dfantonio/Softstarter-using-ARM-STM32F411/latex/stm32f4xx__hal__msp_8c.tex

\hypertarget{stm32f4xx__hal__msp_8c}{}\section{Src/stm32f4xx\+\_\+hal\+\_\+msp.c File Reference}
\label{stm32f4xx__hal__msp_8c}\index{Src/stm32f4xx\+\_\+hal\+\_\+msp.\+c@{Src/stm32f4xx\+\_\+hal\+\_\+msp.\+c}}
{\ttfamily \#include \char`\"{}stm32f4xx\+\_\+hal.\+h\char`\"{}}\newline
\subsection*{Functions}
\begin{DoxyCompactItemize}
\item 
void \hyperlink{stm32f4xx__hal__msp_8c_a47642651029b93e3f9c9edad46bd27b4}{\+\_\+\+Error\+\_\+\+Handler} (char $\ast$, int)
\begin{DoxyCompactList}\small\item\em This function is executed in case of error occurrence. \end{DoxyCompactList}\item 
void \hyperlink{stm32f4xx__hal__msp_8c_ae4fb8e66865c87d0ebab74a726a6891f}{H\+A\+L\+\_\+\+Msp\+Init} (void)
\item 
void \hyperlink{stm32f4xx__hal__msp_8c_aa30863492d5c3103e3e8ce8a63dadd07}{H\+A\+L\+\_\+\+A\+D\+C\+\_\+\+Msp\+Init} (A\+D\+C\+\_\+\+Handle\+Type\+Def $\ast$hadc)
\item 
void \hyperlink{stm32f4xx__hal__msp_8c_a39b0f8e80268ab3e660ead921ad4b22f}{H\+A\+L\+\_\+\+A\+D\+C\+\_\+\+Msp\+De\+Init} (A\+D\+C\+\_\+\+Handle\+Type\+Def $\ast$hadc)
\item 
void \hyperlink{stm32f4xx__hal__msp_8c_abb25ade2f7e3f7aae167bd52270c2b86}{H\+A\+L\+\_\+\+T\+I\+M\+\_\+\+Base\+\_\+\+Msp\+Init} (T\+I\+M\+\_\+\+Handle\+Type\+Def $\ast$htim\+\_\+base)
\item 
void \hyperlink{stm32f4xx__hal__msp_8c_ae70bce6c39d0b570a7523b86738cec4b}{H\+A\+L\+\_\+\+T\+I\+M\+\_\+\+Msp\+Post\+Init} (T\+I\+M\+\_\+\+Handle\+Type\+Def $\ast$htim)
\item 
void \hyperlink{stm32f4xx__hal__msp_8c_a555b8a2d3c7a07341f8cb1255318fa2b}{H\+A\+L\+\_\+\+T\+I\+M\+\_\+\+Base\+\_\+\+Msp\+De\+Init} (T\+I\+M\+\_\+\+Handle\+Type\+Def $\ast$htim\+\_\+base)
\item 
void \hyperlink{stm32f4xx__hal__msp_8c_a0e553b32211877322f949b14801bbfa7}{H\+A\+L\+\_\+\+U\+A\+R\+T\+\_\+\+Msp\+Init} (U\+A\+R\+T\+\_\+\+Handle\+Type\+Def $\ast$huart)
\item 
void \hyperlink{stm32f4xx__hal__msp_8c_a718f39804e3b910d738a0e1e46151188}{H\+A\+L\+\_\+\+U\+A\+R\+T\+\_\+\+Msp\+De\+Init} (U\+A\+R\+T\+\_\+\+Handle\+Type\+Def $\ast$huart)
\end{DoxyCompactItemize}
\subsection*{Variables}
\begin{DoxyCompactItemize}
\item 
D\+M\+A\+\_\+\+Handle\+Type\+Def \hyperlink{stm32f4xx__hal__msp_8c_a1c126854bb1813d31ab4776b21dcc51f}{hdma\+\_\+adc1}
\end{DoxyCompactItemize}

\subsection{Function Documentation}
\mbox{\Hypertarget{stm32f4xx__hal__msp_8c_a47642651029b93e3f9c9edad46bd27b4}\label{stm32f4xx__hal__msp_8c_a47642651029b93e3f9c9edad46bd27b4}} 
\index{stm32f4xx\+\_\+hal\+\_\+msp.\+c@{stm32f4xx\+\_\+hal\+\_\+msp.\+c}!\+\_\+\+Error\+\_\+\+Handler@{\+\_\+\+Error\+\_\+\+Handler}}
\index{\+\_\+\+Error\+\_\+\+Handler@{\+\_\+\+Error\+\_\+\+Handler}!stm32f4xx\+\_\+hal\+\_\+msp.\+c@{stm32f4xx\+\_\+hal\+\_\+msp.\+c}}
\subsubsection{\texorpdfstring{\+\_\+\+Error\+\_\+\+Handler()}{\_Error\_Handler()}}
{\footnotesize\ttfamily void \+\_\+\+Error\+\_\+\+Handler (\begin{DoxyParamCaption}\item[{char $\ast$}]{file,  }\item[{int}]{line }\end{DoxyParamCaption})}

This function is executed in case of error occurrence. 

\begin{DoxyParams}{Parameters}
{\em file} & The file name as string. \\
\hline
{\em line} & The line in file as a number. \\
\hline
\end{DoxyParams}

\begin{DoxyRetVals}{Return values}
{\em None} & \\
\hline
\end{DoxyRetVals}

Definition at line 1010 of file main.\+c.

Referenced by H\+A\+L\+\_\+\+A\+D\+C\+\_\+\+Msp\+Init(), and System\+Clock\+\_\+\+Config().

\mbox{\Hypertarget{stm32f4xx__hal__msp_8c_a39b0f8e80268ab3e660ead921ad4b22f}\label{stm32f4xx__hal__msp_8c_a39b0f8e80268ab3e660ead921ad4b22f}} 
\index{stm32f4xx\+\_\+hal\+\_\+msp.\+c@{stm32f4xx\+\_\+hal\+\_\+msp.\+c}!H\+A\+L\+\_\+\+A\+D\+C\+\_\+\+Msp\+De\+Init@{H\+A\+L\+\_\+\+A\+D\+C\+\_\+\+Msp\+De\+Init}}
\index{H\+A\+L\+\_\+\+A\+D\+C\+\_\+\+Msp\+De\+Init@{H\+A\+L\+\_\+\+A\+D\+C\+\_\+\+Msp\+De\+Init}!stm32f4xx\+\_\+hal\+\_\+msp.\+c@{stm32f4xx\+\_\+hal\+\_\+msp.\+c}}
\subsubsection{\texorpdfstring{H\+A\+L\+\_\+\+A\+D\+C\+\_\+\+Msp\+De\+Init()}{HAL\_ADC\_MspDeInit()}}
{\footnotesize\ttfamily void H\+A\+L\+\_\+\+A\+D\+C\+\_\+\+Msp\+De\+Init (\begin{DoxyParamCaption}\item[{A\+D\+C\+\_\+\+Handle\+Type\+Def $\ast$}]{hadc }\end{DoxyParamCaption})}

A\+D\+C1 G\+P\+IO Configuration P\+A4 -\/-\/-\/---$>$ A\+D\+C1\+\_\+\+I\+N4

Definition at line 139 of file stm32f4xx\+\_\+hal\+\_\+msp.\+c.

\mbox{\Hypertarget{stm32f4xx__hal__msp_8c_aa30863492d5c3103e3e8ce8a63dadd07}\label{stm32f4xx__hal__msp_8c_aa30863492d5c3103e3e8ce8a63dadd07}} 
\index{stm32f4xx\+\_\+hal\+\_\+msp.\+c@{stm32f4xx\+\_\+hal\+\_\+msp.\+c}!H\+A\+L\+\_\+\+A\+D\+C\+\_\+\+Msp\+Init@{H\+A\+L\+\_\+\+A\+D\+C\+\_\+\+Msp\+Init}}
\index{H\+A\+L\+\_\+\+A\+D\+C\+\_\+\+Msp\+Init@{H\+A\+L\+\_\+\+A\+D\+C\+\_\+\+Msp\+Init}!stm32f4xx\+\_\+hal\+\_\+msp.\+c@{stm32f4xx\+\_\+hal\+\_\+msp.\+c}}
\subsubsection{\texorpdfstring{H\+A\+L\+\_\+\+A\+D\+C\+\_\+\+Msp\+Init()}{HAL\_ADC\_MspInit()}}
{\footnotesize\ttfamily void H\+A\+L\+\_\+\+A\+D\+C\+\_\+\+Msp\+Init (\begin{DoxyParamCaption}\item[{A\+D\+C\+\_\+\+Handle\+Type\+Def $\ast$}]{hadc }\end{DoxyParamCaption})}

A\+D\+C1 G\+P\+IO Configuration P\+A4 -\/-\/-\/---$>$ A\+D\+C1\+\_\+\+I\+N4

Definition at line 90 of file stm32f4xx\+\_\+hal\+\_\+msp.\+c.

References \+\_\+\+Error\+\_\+\+Handler(), and hdma\+\_\+adc1.

\mbox{\Hypertarget{stm32f4xx__hal__msp_8c_ae4fb8e66865c87d0ebab74a726a6891f}\label{stm32f4xx__hal__msp_8c_ae4fb8e66865c87d0ebab74a726a6891f}} 
\index{stm32f4xx\+\_\+hal\+\_\+msp.\+c@{stm32f4xx\+\_\+hal\+\_\+msp.\+c}!H\+A\+L\+\_\+\+Msp\+Init@{H\+A\+L\+\_\+\+Msp\+Init}}
\index{H\+A\+L\+\_\+\+Msp\+Init@{H\+A\+L\+\_\+\+Msp\+Init}!stm32f4xx\+\_\+hal\+\_\+msp.\+c@{stm32f4xx\+\_\+hal\+\_\+msp.\+c}}
\subsubsection{\texorpdfstring{H\+A\+L\+\_\+\+Msp\+Init()}{HAL\_MspInit()}}
{\footnotesize\ttfamily void H\+A\+L\+\_\+\+Msp\+Init (\begin{DoxyParamCaption}\item[{void}]{ }\end{DoxyParamCaption})}

Initializes the Global M\+SP. 

Definition at line 61 of file stm32f4xx\+\_\+hal\+\_\+msp.\+c.

\mbox{\Hypertarget{stm32f4xx__hal__msp_8c_a555b8a2d3c7a07341f8cb1255318fa2b}\label{stm32f4xx__hal__msp_8c_a555b8a2d3c7a07341f8cb1255318fa2b}} 
\index{stm32f4xx\+\_\+hal\+\_\+msp.\+c@{stm32f4xx\+\_\+hal\+\_\+msp.\+c}!H\+A\+L\+\_\+\+T\+I\+M\+\_\+\+Base\+\_\+\+Msp\+De\+Init@{H\+A\+L\+\_\+\+T\+I\+M\+\_\+\+Base\+\_\+\+Msp\+De\+Init}}
\index{H\+A\+L\+\_\+\+T\+I\+M\+\_\+\+Base\+\_\+\+Msp\+De\+Init@{H\+A\+L\+\_\+\+T\+I\+M\+\_\+\+Base\+\_\+\+Msp\+De\+Init}!stm32f4xx\+\_\+hal\+\_\+msp.\+c@{stm32f4xx\+\_\+hal\+\_\+msp.\+c}}
\subsubsection{\texorpdfstring{H\+A\+L\+\_\+\+T\+I\+M\+\_\+\+Base\+\_\+\+Msp\+De\+Init()}{HAL\_TIM\_Base\_MspDeInit()}}
{\footnotesize\ttfamily void H\+A\+L\+\_\+\+T\+I\+M\+\_\+\+Base\+\_\+\+Msp\+De\+Init (\begin{DoxyParamCaption}\item[{T\+I\+M\+\_\+\+Handle\+Type\+Def $\ast$}]{htim\+\_\+base }\end{DoxyParamCaption})}

T\+I\+M1 G\+P\+IO Configuration P\+A8 ------$>$ T\+I\+M1\+\_\+\+C\+H1

T\+I\+M2 G\+P\+IO Configuration P\+A0-\/\+W\+K\+UP ------$>$ T\+I\+M2\+\_\+\+C\+H1 P\+A1 ------$>$ T\+I\+M2\+\_\+\+C\+H2

T\+I\+M4 G\+P\+IO Configuration P\+B6 -\/-\/-\/---$>$ T\+I\+M4\+\_\+\+C\+H1

Definition at line 284 of file stm32f4xx\+\_\+hal\+\_\+msp.\+c.

\mbox{\Hypertarget{stm32f4xx__hal__msp_8c_abb25ade2f7e3f7aae167bd52270c2b86}\label{stm32f4xx__hal__msp_8c_abb25ade2f7e3f7aae167bd52270c2b86}} 
\index{stm32f4xx\+\_\+hal\+\_\+msp.\+c@{stm32f4xx\+\_\+hal\+\_\+msp.\+c}!H\+A\+L\+\_\+\+T\+I\+M\+\_\+\+Base\+\_\+\+Msp\+Init@{H\+A\+L\+\_\+\+T\+I\+M\+\_\+\+Base\+\_\+\+Msp\+Init}}
\index{H\+A\+L\+\_\+\+T\+I\+M\+\_\+\+Base\+\_\+\+Msp\+Init@{H\+A\+L\+\_\+\+T\+I\+M\+\_\+\+Base\+\_\+\+Msp\+Init}!stm32f4xx\+\_\+hal\+\_\+msp.\+c@{stm32f4xx\+\_\+hal\+\_\+msp.\+c}}
\subsubsection{\texorpdfstring{H\+A\+L\+\_\+\+T\+I\+M\+\_\+\+Base\+\_\+\+Msp\+Init()}{HAL\_TIM\_Base\_MspInit()}}
{\footnotesize\ttfamily void H\+A\+L\+\_\+\+T\+I\+M\+\_\+\+Base\+\_\+\+Msp\+Init (\begin{DoxyParamCaption}\item[{T\+I\+M\+\_\+\+Handle\+Type\+Def $\ast$}]{htim\+\_\+base }\end{DoxyParamCaption})}

T\+I\+M1 G\+P\+IO Configuration P\+A8 ------$>$ T\+I\+M1\+\_\+\+C\+H1

T\+I\+M2 G\+P\+IO Configuration P\+A1 ------$>$ T\+I\+M2\+\_\+\+C\+H2

T\+I\+M4 G\+P\+IO Configuration P\+B6 -\/-\/-\/---$>$ T\+I\+M4\+\_\+\+C\+H1

Definition at line 167 of file stm32f4xx\+\_\+hal\+\_\+msp.\+c.

\mbox{\Hypertarget{stm32f4xx__hal__msp_8c_ae70bce6c39d0b570a7523b86738cec4b}\label{stm32f4xx__hal__msp_8c_ae70bce6c39d0b570a7523b86738cec4b}} 
\index{stm32f4xx\+\_\+hal\+\_\+msp.\+c@{stm32f4xx\+\_\+hal\+\_\+msp.\+c}!H\+A\+L\+\_\+\+T\+I\+M\+\_\+\+Msp\+Post\+Init@{H\+A\+L\+\_\+\+T\+I\+M\+\_\+\+Msp\+Post\+Init}}
\index{H\+A\+L\+\_\+\+T\+I\+M\+\_\+\+Msp\+Post\+Init@{H\+A\+L\+\_\+\+T\+I\+M\+\_\+\+Msp\+Post\+Init}!stm32f4xx\+\_\+hal\+\_\+msp.\+c@{stm32f4xx\+\_\+hal\+\_\+msp.\+c}}
\subsubsection{\texorpdfstring{H\+A\+L\+\_\+\+T\+I\+M\+\_\+\+Msp\+Post\+Init()}{HAL\_TIM\_MspPostInit()}}
{\footnotesize\ttfamily void H\+A\+L\+\_\+\+T\+I\+M\+\_\+\+Msp\+Post\+Init (\begin{DoxyParamCaption}\item[{T\+I\+M\+\_\+\+Handle\+Type\+Def $\ast$}]{htim }\end{DoxyParamCaption})}

T\+I\+M2 G\+P\+IO Configuration P\+A0-\/\+W\+K\+UP -\/-\/-\/---$>$ T\+I\+M2\+\_\+\+C\+H1

Definition at line 257 of file stm32f4xx\+\_\+hal\+\_\+msp.\+c.

\mbox{\Hypertarget{stm32f4xx__hal__msp_8c_a718f39804e3b910d738a0e1e46151188}\label{stm32f4xx__hal__msp_8c_a718f39804e3b910d738a0e1e46151188}} 
\index{stm32f4xx\+\_\+hal\+\_\+msp.\+c@{stm32f4xx\+\_\+hal\+\_\+msp.\+c}!H\+A\+L\+\_\+\+U\+A\+R\+T\+\_\+\+Msp\+De\+Init@{H\+A\+L\+\_\+\+U\+A\+R\+T\+\_\+\+Msp\+De\+Init}}
\index{H\+A\+L\+\_\+\+U\+A\+R\+T\+\_\+\+Msp\+De\+Init@{H\+A\+L\+\_\+\+U\+A\+R\+T\+\_\+\+Msp\+De\+Init}!stm32f4xx\+\_\+hal\+\_\+msp.\+c@{stm32f4xx\+\_\+hal\+\_\+msp.\+c}}
\subsubsection{\texorpdfstring{H\+A\+L\+\_\+\+U\+A\+R\+T\+\_\+\+Msp\+De\+Init()}{HAL\_UART\_MspDeInit()}}
{\footnotesize\ttfamily void H\+A\+L\+\_\+\+U\+A\+R\+T\+\_\+\+Msp\+De\+Init (\begin{DoxyParamCaption}\item[{U\+A\+R\+T\+\_\+\+Handle\+Type\+Def $\ast$}]{huart }\end{DoxyParamCaption})}

U\+S\+A\+R\+T2 G\+P\+IO Configuration P\+A2 -\/-\/-\/---$>$ U\+S\+A\+R\+T2\+\_\+\+TX P\+A3 -\/-\/-\/---$>$ U\+S\+A\+R\+T2\+\_\+\+RX

Definition at line 390 of file stm32f4xx\+\_\+hal\+\_\+msp.\+c.

\mbox{\Hypertarget{stm32f4xx__hal__msp_8c_a0e553b32211877322f949b14801bbfa7}\label{stm32f4xx__hal__msp_8c_a0e553b32211877322f949b14801bbfa7}} 
\index{stm32f4xx\+\_\+hal\+\_\+msp.\+c@{stm32f4xx\+\_\+hal\+\_\+msp.\+c}!H\+A\+L\+\_\+\+U\+A\+R\+T\+\_\+\+Msp\+Init@{H\+A\+L\+\_\+\+U\+A\+R\+T\+\_\+\+Msp\+Init}}
\index{H\+A\+L\+\_\+\+U\+A\+R\+T\+\_\+\+Msp\+Init@{H\+A\+L\+\_\+\+U\+A\+R\+T\+\_\+\+Msp\+Init}!stm32f4xx\+\_\+hal\+\_\+msp.\+c@{stm32f4xx\+\_\+hal\+\_\+msp.\+c}}
\subsubsection{\texorpdfstring{H\+A\+L\+\_\+\+U\+A\+R\+T\+\_\+\+Msp\+Init()}{HAL\_UART\_MspInit()}}
{\footnotesize\ttfamily void H\+A\+L\+\_\+\+U\+A\+R\+T\+\_\+\+Msp\+Init (\begin{DoxyParamCaption}\item[{U\+A\+R\+T\+\_\+\+Handle\+Type\+Def $\ast$}]{huart }\end{DoxyParamCaption})}

U\+S\+A\+R\+T2 G\+P\+IO Configuration P\+A2 -\/-\/-\/---$>$ U\+S\+A\+R\+T2\+\_\+\+TX P\+A3 -\/-\/-\/---$>$ U\+S\+A\+R\+T2\+\_\+\+RX

Definition at line 357 of file stm32f4xx\+\_\+hal\+\_\+msp.\+c.

\subsection{Variable Documentation}
\mbox{\Hypertarget{stm32f4xx__hal__msp_8c_a1c126854bb1813d31ab4776b21dcc51f}\label{stm32f4xx__hal__msp_8c_a1c126854bb1813d31ab4776b21dcc51f}} 
\index{stm32f4xx\+\_\+hal\+\_\+msp.\+c@{stm32f4xx\+\_\+hal\+\_\+msp.\+c}!hdma\+\_\+adc1@{hdma\+\_\+adc1}}
\index{hdma\+\_\+adc1@{hdma\+\_\+adc1}!stm32f4xx\+\_\+hal\+\_\+msp.\+c@{stm32f4xx\+\_\+hal\+\_\+msp.\+c}}
\subsubsection{\texorpdfstring{hdma\+\_\+adc1}{hdma\_adc1}}
{\footnotesize\ttfamily D\+M\+A\+\_\+\+Handle\+Type\+Def hdma\+\_\+adc1}

File Name \+: \hyperlink{stm32f4xx__hal__msp_8c}{stm32f4xx\+\_\+hal\+\_\+msp.\+c} Description \+: This file provides code for the M\+SP Initialization and de-\/\+Initialization codes.

This notice applies to any and all portions of this file that are not between comment pairs U\+S\+ER C\+O\+DE B\+E\+G\+IN and U\+S\+ER C\+O\+DE E\+ND. Other portions of this file, whether inserted by the user or by software development tools are owned by their respective copyright owners.

Copyright (c) 2018 S\+T\+Microelectronics International N.\+V. All rights reserved.

Redistribution and use in source and binary forms, with or without modification, are permitted, provided that the following conditions are met\+:

\begin{DoxyEnumerate}
\item Redistribution of source code must retain the above copyright notice, this list of conditions and the following disclaimer.
\item Redistributions in binary form must reproduce the above copyright notice, this list of conditions and the following disclaimer in the documentation and/or other materials provided with the distribution.
\item Neither the name of S\+T\+Microelectronics nor the names of other contributors to this software may be used to endorse or promote products derived from this software without specific written permission.
\item This software, including modifications and/or derivative works of this software, must execute solely and exclusively on microcontroller or microprocessor devices manufactured by or for S\+T\+Microelectronics.
\item Redistribution and use of this software other than as permitted under this license is void and will automatically terminate your rights under this license.
\end{DoxyEnumerate}

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

Definition at line 61 of file main.\+c.

Referenced by H\+A\+L\+\_\+\+A\+D\+C\+\_\+\+Msp\+Init().
