dfantonio/Softstarter-using-ARM-STM32F411/latex/modules.tex

\section{Modules}
Here is a list of all modules\+:\begin{DoxyCompactList}
\item \contentsline{section}{S\+T\+M32\+F7xx\+\_\+\+H\+A\+L\+\_\+\+Examples}{\pageref{group___s_t_m32_f7xx___h_a_l___examples}}{}
\begin{DoxyCompactList}
\item \contentsline{section}{H\+A\+L\+\_\+\+Time\+Base}{\pageref{group___h_a_l___time_base}}{}
\end{DoxyCompactList}
\item \contentsline{section}{C\+M\+S\+IS}{\pageref{group___c_m_s_i_s}}{}
\begin{DoxyCompactList}
\item \contentsline{section}{Stm32f4xx\+\_\+system}{\pageref{group__stm32f4xx__system}}{}
\begin{DoxyCompactList}
\item \contentsline{section}{S\+T\+M32\+F4xx\+\_\+\+System\+\_\+\+Private\+\_\+\+Includes}{\pageref{group___s_t_m32_f4xx___system___private___includes}}{}
\item \contentsline{section}{S\+T\+M32\+F4xx\+\_\+\+System\+\_\+\+Private\+\_\+\+Types\+Definitions}{\pageref{group___s_t_m32_f4xx___system___private___types_definitions}}{}
\item \contentsline{section}{S\+T\+M32\+F4xx\+\_\+\+System\+\_\+\+Private\+\_\+\+Defines}{\pageref{group___s_t_m32_f4xx___system___private___defines}}{}
\item \contentsline{section}{S\+T\+M32\+F4xx\+\_\+\+System\+\_\+\+Private\+\_\+\+Macros}{\pageref{group___s_t_m32_f4xx___system___private___macros}}{}
\item \contentsline{section}{S\+T\+M32\+F4xx\+\_\+\+System\+\_\+\+Private\+\_\+\+Variables}{\pageref{group___s_t_m32_f4xx___system___private___variables}}{}
\item \contentsline{section}{S\+T\+M32\+F4xx\+\_\+\+System\+\_\+\+Private\+\_\+\+Function\+Prototypes}{\pageref{group___s_t_m32_f4xx___system___private___function_prototypes}}{}
\item \contentsline{section}{S\+T\+M32\+F4xx\+\_\+\+System\+\_\+\+Private\+\_\+\+Functions}{\pageref{group___s_t_m32_f4xx___system___private___functions}}{}
\end{DoxyCompactList}
\end{DoxyCompactList}
\end{DoxyCompactList}
