dfantonio/Softstarter-using-ARM-STM32F411/latex/stm32f4xx__hal__timebase___t_i_m_8c.tex

\hypertarget{stm32f4xx__hal__timebase___t_i_m_8c}{}\section{Src/stm32f4xx\+\_\+hal\+\_\+timebase\+\_\+\+T\+IM.c File Reference}
\label{stm32f4xx__hal__timebase___t_i_m_8c}\index{Src/stm32f4xx\+\_\+hal\+\_\+timebase\+\_\+\+T\+I\+M.\+c@{Src/stm32f4xx\+\_\+hal\+\_\+timebase\+\_\+\+T\+I\+M.\+c}}

H\+AL time base based on the hardware T\+IM.  

{\ttfamily \#include \char`\"{}stm32f4xx\+\_\+hal.\+h\char`\"{}}\newline
{\ttfamily \#include \char`\"{}stm32f4xx\+\_\+hal\+\_\+tim.\+h\char`\"{}}\newline
\subsection*{Functions}
\begin{DoxyCompactItemize}
\item 
H\+A\+L\+\_\+\+Status\+Type\+Def \hyperlink{group___h_a_l___time_base_ga879cdb21ef051eb81ec51c18147397d5}{H\+A\+L\+\_\+\+Init\+Tick} (uint32\+\_\+t Tick\+Priority)
\begin{DoxyCompactList}\small\item\em This function configures the T\+I\+M11 as a time base source. The time source is configured to have 1ms time base with a dedicated Tick interrupt priority. \end{DoxyCompactList}\item 
void \hyperlink{group___h_a_l___time_base_gaaf651af2afe688a991c657f64f8fa5f9}{H\+A\+L\+\_\+\+Suspend\+Tick} (void)
\begin{DoxyCompactList}\small\item\em Suspend Tick increment. \end{DoxyCompactList}\item 
void \hyperlink{group___h_a_l___time_base_ga24e0ee9dae1ec0f9d19200f5575ff790}{H\+A\+L\+\_\+\+Resume\+Tick} (void)
\begin{DoxyCompactList}\small\item\em Resume Tick increment. \end{DoxyCompactList}\end{DoxyCompactItemize}
\subsection*{Variables}
\begin{DoxyCompactItemize}
\item 
T\+I\+M\+\_\+\+Handle\+Type\+Def \hyperlink{group___h_a_l___time_base_ga2f22f985c4f33318fdcd4cc996623bf4}{htim11}
\item 
uint32\+\_\+t \hyperlink{group___h_a_l___time_base_gad252e5fa14fe03797c816cfb14962693}{uw\+Increment\+State} = 0
\end{DoxyCompactItemize}

\subsection{Detailed Description}
H\+AL time base based on the hardware T\+IM. 

This notice applies to any and all portions of this file that are not between comment pairs U\+S\+ER C\+O\+DE B\+E\+G\+IN and U\+S\+ER C\+O\+DE E\+ND. Other portions of this file, whether inserted by the user or by software development tools are owned by their respective copyright owners.

Copyright (c) 2018 S\+T\+Microelectronics International N.\+V. All rights reserved.

Redistribution and use in source and binary forms, with or without modification, are permitted, provided that the following conditions are met\+:

\begin{DoxyEnumerate}
\item Redistribution of source code must retain the above copyright notice, this list of conditions and the following disclaimer.
\item Redistributions in binary form must reproduce the above copyright notice, this list of conditions and the following disclaimer in the documentation and/or other materials provided with the distribution.
\item Neither the name of S\+T\+Microelectronics nor the names of other contributors to this software may be used to endorse or promote products derived from this software without specific written permission.
\item This software, including modifications and/or derivative works of this software, must execute solely and exclusively on microcontroller or microprocessor devices manufactured by or for S\+T\+Microelectronics.
\item Redistribution and use of this software other than as permitted under this license is void and will automatically terminate your rights under this license.
\end{DoxyEnumerate}

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
