dfantonio/Softstarter-using-ARM-STM32F411/Relatório/Diagrama da SoftStarter.png

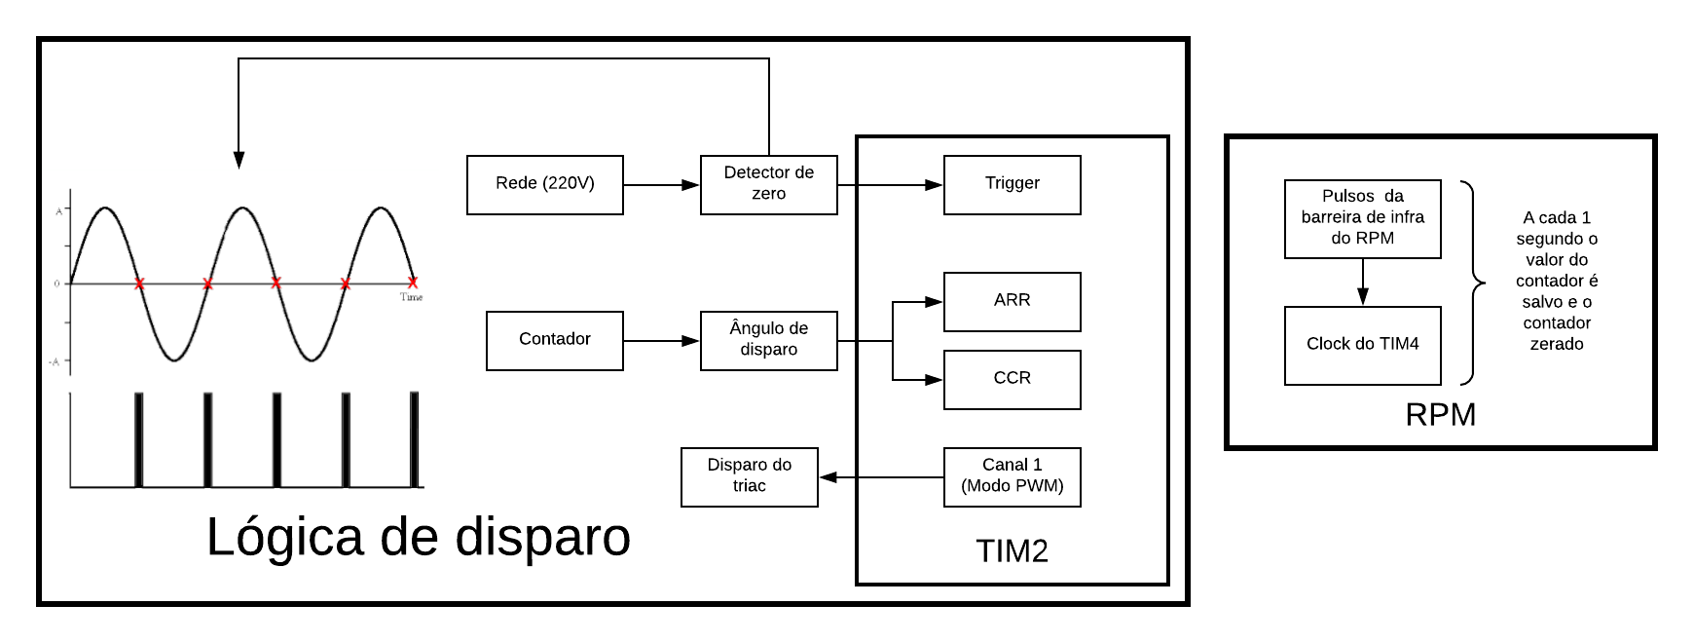
Relatório/Diagrama da SoftStarter.png
