dfantonio/Softstarter-using-ARM-STM32F411/Schematics/Disparo pro TRIAC.png

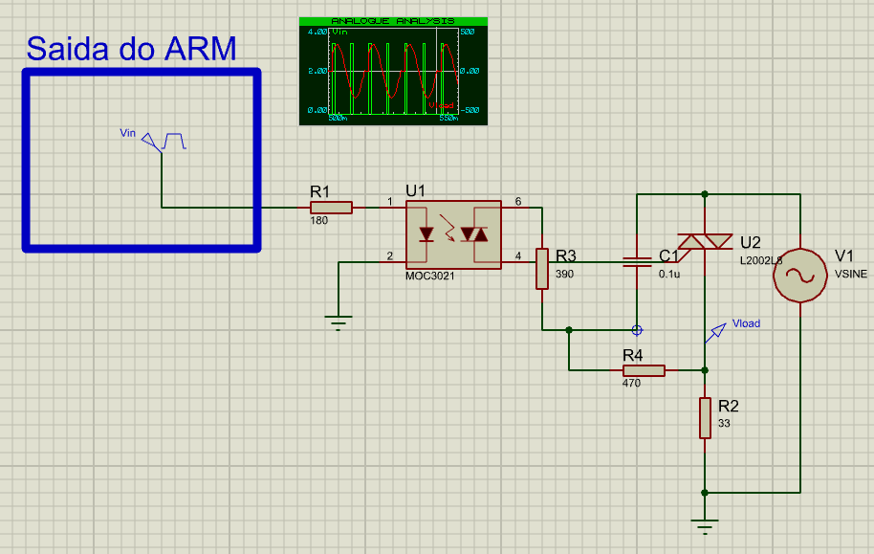
Schematics/Disparo pro TRIAC.png
