dfantonio/Softstarter-using-ARM-STM32F411/Schematics/Retificador de precisão.png

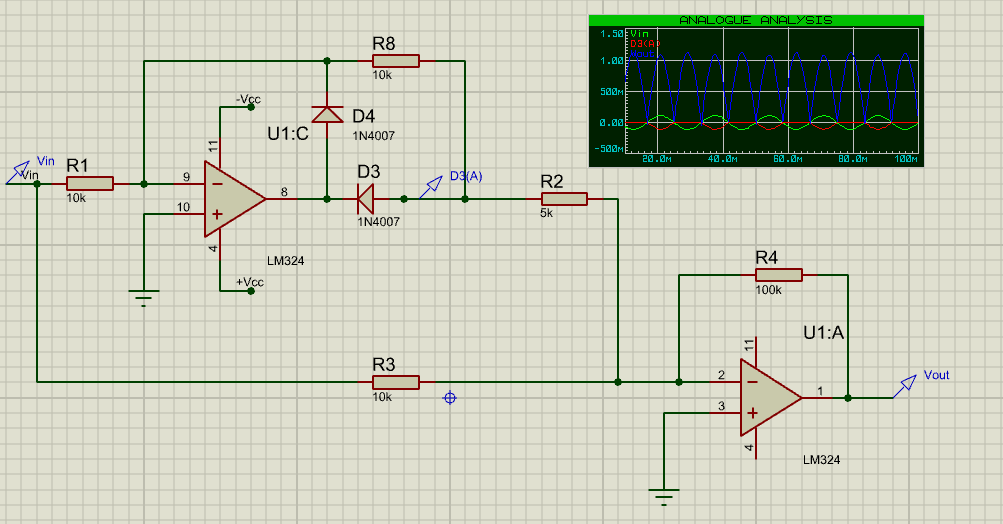
Schematics/Retificador de precisão.png
