dfantonio/Softstarter-using-ARM-STM32F411/Schematics/Zero Crossing Detector.png

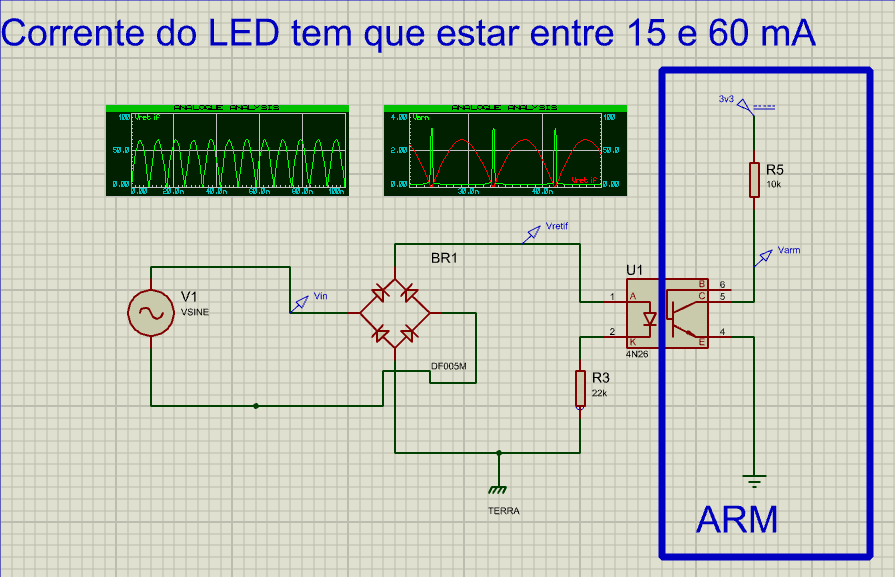
Schematics/Zero Crossing Detector.png
