dfantonio/Softstarter-using-ARM-STM32F411/(list of files, drawings)

Other design files:
Schematics/Disparo pro TRIAC.pdsprj
Schematics/Retificador de precisão.pdsprj
Schematics/Zero Crossing Detector.pdsprj
