dfantonio/Softstarter-using-ARM-STM32F411/Src/main.c

/**
 ******************************************************************************
 * @file           : main.c
 * @brief          : Main program body
 ******************************************************************************
 * This notice applies to any and all portions of this file
 * that are not between comment pairs USER CODE BEGIN and
 * USER CODE END. Other portions of this file, whether
 * inserted by the user or by software development tools
 * are owned by their respective copyright owners.
 *
 * Copyright (c) 2018 STMicroelectronics International N.V.
 * All rights reserved.
 *
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
 ******************************************************************************
 */
/* Includes ------------------------------------------------------------------*/
#include "main.h"
#include "math.h"
#include "stdio.h"
#include "stm32f4xx_hal.h"
#include "cmsis_os.h"

ADC_HandleTypeDef hadc1;
DMA_HandleTypeDef hdma_adc1;

TIM_HandleTypeDef htim1;
TIM_HandleTypeDef htim2;
TIM_HandleTypeDef htim3;
TIM_HandleTypeDef htim4;

UART_HandleTypeDef huart2;

osThreadId RampHandle;
osThreadId VerifyHandle;
osThreadId CounterHandle;
osThreadId SerialHandle;
osThreadId OverCurrentHandle;
osThreadId ComecaHandle;
osThreadId RPMHandle;

/* USER CODE BEGIN PV */

/* USER CODE END PV */

void SystemClock_Config(void);
static void MX_GPIO_Init(void);
static void MX_DMA_Init(void);
static void MX_USART2_UART_Init(void);
static void MX_TIM2_Init(void);
static void MX_TIM1_Init(void);
static void MX_ADC1_Init(void);
static void MX_TIM3_Init(void);
static void MX_TIM4_Init(void);

//! Counts up or down depending on the settings
void RampTask(void const * argument);

//! Monitors the current percentage and if the board button is pressed
void VerifyTask(void const * argument);

//! Verifies for the end of ramps and 150% overcurrent protection
void CounterTask(void const * argument);

//! Responsable for the serial stuff
void SerialTask(void const * argument);

//! Calculates the RMS current based on the ADC read
void OverCurrentTask(void const * argument);

//! Initialize all the peripherals and then lock the thread itself
void Comeca_Task(void const * argument);

//! Measure and calculates the RPM
void RPMTask(void const * argument);

void HAL_TIM_MspPostInit(TIM_HandleTypeDef *htim);

/* USER CODE BEGIN PFP */
//! If it's on the soft is in a ramp
char fg_Start = 0;

//! Shows if the soft is idle
char fg_End = 1;

//! Indicates if the ADC conversion is over
char fg_ADC_current = 0;

//! Is the acceleration time in milliseconds
int tempo_up = 10000;

//! Deceleration time in milliseconds
int tempo_down = 7000;

//! time used as a reference for the ramps in milliseconds
float tempo;

//! Delay to the pulse on triac in microseconds
int PULSE_DELAY = 8330;

//! Width of the triac's pulse in microseconds
int PULSE_WIDTH = 1;

//! Reference pulse width for the triac in microseconds
int PULSE_WIDTH_CONST = 1000;

//! Minimal delay time to triac
int minimal_delay = 500;

//! It's part of the process to determine the PULSE_DELAY
float delay;

//! Defines if it's a acceleration or deceleration ramp
int RampUp = 1;

//! Is the RPM of the motor
int RPM;

//! The time variable responsible for the entire counting process
int counter;

//! Is the current RMS
int Irms;

//! Is the relation between the 12 bits from the ADC and the current itself. It basically converts the voltage into current
float relation = 1.4325;

//! Is the nominal current of the motor
int corrente_nominal = 400;

//! Indicates if the soft shall start through the serial
int fg_serial = 0;

//! Is a vector of reads from the ADC
uint16_t adc_current[16];

/* USER CODE END PFP */

/* USER CODE BEGIN 0 */

//! Is the callback from the DMA which stands for the end of conversion
void HAL_ADC_ConvCpltCallback(ADC_HandleTypeDef* hadc) {
	fg_ADC_current = 1;
}
/* USER CODE END 0 */

/**
 * @brief  The application entry point.
 *
 * @retval None
 */
int main(void) {
	/* MCU Configuration----------------------------------------------------------*/

	/* Reset of all peripherals, Initializes the Flash interface and the Systick. */
	HAL_Init();

	/* Configure the system clock */
	SystemClock_Config();

	/* Initialize all configured peripherals */
	MX_GPIO_Init();
	MX_DMA_Init();
	MX_USART2_UART_Init();
	MX_TIM2_Init();
	MX_TIM1_Init();
	MX_ADC1_Init();
	MX_TIM3_Init();
	MX_TIM4_Init();
	/* USER CODE BEGIN RTOS_MUTEX */
	/* add mutexes, ... */
	/* USER CODE END RTOS_MUTEX */

	/* USER CODE BEGIN RTOS_SEMAPHORES */
	/* add semaphores, ... */
	/* USER CODE END RTOS_SEMAPHORES */

	/* USER CODE BEGIN RTOS_TIMERS */
	/* start timers, add new ones, ... */
	/* USER CODE END RTOS_TIMERS */

	/* Create the thread(s) */
	/* definition and creation of Ramp */
	osThreadDef(Ramp, RampTask, osPriorityNormal, 0, 128);
	RampHandle = osThreadCreate(osThread(Ramp), NULL);

	/* definition and creation of Verify */
	osThreadDef(Verify, VerifyTask, osPriorityNormal, 0, 128);
	VerifyHandle = osThreadCreate(osThread(Verify), NULL);

	/* definition and creation of Counter */
	osThreadDef(Counter, CounterTask, osPriorityNormal, 0, 128);
	CounterHandle = osThreadCreate(osThread(Counter), NULL);

	/* definition and creation of Serial */
	osThreadDef(Serial, SerialTask, osPriorityNormal, 0, 128);
	SerialHandle = osThreadCreate(osThread(Serial), NULL);

	/* definition and creation of OverCurrent */
	osThreadDef(OverCurrent, OverCurrentTask, osPriorityNormal, 0, 128);
	OverCurrentHandle = osThreadCreate(osThread(OverCurrent), NULL);

	/* definition and creation of Comeca */
	osThreadDef(Comeca, Comeca_Task, osPriorityRealtime, 0, 128);
	ComecaHandle = osThreadCreate(osThread(Comeca), NULL);

	/* definition and creation of RPM */
	osThreadDef(RPM, RPMTask, osPriorityNormal, 0, 128);
	RPMHandle = osThreadCreate(osThread(RPM), NULL);

	/* USER CODE BEGIN RTOS_THREADS */
	/* add threads, ... */
	/* USER CODE END RTOS_THREADS */

	/* USER CODE BEGIN RTOS_QUEUES */
	/* add queues, ... */
	/* USER CODE END RTOS_QUEUES */

	/* Start scheduler */
	osKernelStart();

	/* We should never get here as control is now taken by the scheduler */

	/* Infinite loop */
	/* USER CODE BEGIN WHILE */
	while (1) {

		/* USER CODE END WHILE */

		/* USER CODE BEGIN 3 */

	}
	/* USER CODE END 3 */

}

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
/* RampTask function */
void RampTask(void const * argument) {

	/* USER CODE BEGIN 5 */
	/* Infinite loop */
	for (;;) {
		if (__HAL_TIM_GET_COUNTER(&htim2) <= (PULSE_DELAY - 500)) {
			__HAL_TIM_SET_AUTORELOAD(&htim2, PULSE_DELAY + PULSE_WIDTH - 1);
			__HAL_TIM_SET_COMPARE(&htim2, TIM_CHANNEL_1, PULSE_DELAY);

		}
		osDelay(25);
	}
	/* USER CODE END 5 */
}

/* VerifyTask function */
void VerifyTask(void const * argument) {
	/* USER CODE BEGIN VerifyTask */
	/* Infinite loop */

	for (;;) {
		if ((HAL_GPIO_ReadPin(Button_GPIO_Port, Button_Pin) == GPIO_PIN_RESET
				|| fg_serial) && fg_End == 1) {

			fg_serial = 0;
			fg_Start = 1;
			fg_End = 0;
			if (RampUp == 1) {
				tempo = tempo_up;
				counter = tempo;
			} else {
				HAL_GPIO_WritePin(bypass_relay_GPIO_Port, bypass_relay_Pin,
						GPIO_PIN_RESET);
				tempo = tempo_down;
				counter = 0;
			}
		}

		if (Irms >= 0 && Irms < corrente_nominal * 1.5) {
			HAL_GPIO_WritePin(GPIOC, Green_LED_Pin, GPIO_PIN_SET);
			HAL_GPIO_WritePin(GPIOC, Yellow_LED_Pin, GPIO_PIN_RESET);
			HAL_GPIO_WritePin(GPIOC, Red_LED_Pin, GPIO_PIN_RESET);
		}

		if (Irms > corrente_nominal * 1.5 && Irms < corrente_nominal * 2) {
			HAL_GPIO_WritePin(GPIOC, Green_LED_Pin, GPIO_PIN_RESET);
			HAL_GPIO_WritePin(GPIOC, Yellow_LED_Pin, GPIO_PIN_SET);
			HAL_GPIO_WritePin(GPIOC, Red_LED_Pin, GPIO_PIN_RESET);
		}

		if (Irms > corrente_nominal * 2) {
			HAL_GPIO_WritePin(GPIOC, Green_LED_Pin, GPIO_PIN_RESET);
			HAL_GPIO_WritePin(GPIOC, Yellow_LED_Pin, GPIO_PIN_RESET);
			HAL_GPIO_WritePin(GPIOC, Red_LED_Pin, GPIO_PIN_SET);

			HAL_GPIO_WritePin(bypass_relay_GPIO_Port, bypass_relay_Pin,
					GPIO_PIN_RESET);
			counter = 1;
			RampUp = 1;
			fg_Start = 0;
			fg_End = 1;
			PULSE_DELAY = 8330;
			PULSE_WIDTH = 1;
		}

		osDelay(20);
	}
	/* USER CODE END VerifyTask */
}

/* CounterTask function */
void CounterTask(void const * argument) {
	/* USER CODE BEGIN CounterTask */
	/* Infinite loop */
	for (;;) {

		//Verifies if acceleration ramp is over
		if (RampUp == 1 && counter <= 0) {
			HAL_GPIO_WritePin(bypass_relay_GPIO_Port, bypass_relay_Pin,
					GPIO_PIN_SET);
			fg_Start = 0;
			fg_End = 1;
			RampUp = !RampUp;
		}

		//Verifies if deceleration ramp is over
		if (RampUp == 0 && counter >= tempo) {
			fg_Start = 0;
			fg_End = 1;
			RampUp = !RampUp;
		}
		if (fg_Start) {
			if (RampUp == 1) {
				counter = counter - 2;
				if (HAL_GPIO_ReadPin(GPIOC, Yellow_LED_Pin) == GPIO_PIN_SET)
					counter = counter + 2;
			}
			if (RampUp == 0)
				counter = counter + 2;

			delay = (counter / tempo * (8333 - minimal_delay));
			PULSE_DELAY = delay + minimal_delay;

		}

		if ((PULSE_DELAY >= (8333 - PULSE_WIDTH) && RampUp == 0))
			PULSE_WIDTH = (8333 - PULSE_DELAY);
		if ((PULSE_WIDTH < PULSE_WIDTH_CONST && RampUp == 1))
			PULSE_WIDTH = (8333 - PULSE_DELAY);

		osDelay(2);
	}
	/* USER CODE END CounterTask */
}

/* SerialTask function */
void SerialTask(void const * argument) {
	/* USER CODE BEGIN SerialTask */
	/* Infinite loop */
	char rx, tempo_serial[6];
	char texto[100];
	int fg_status = 0;
	int size, aux;
	int numero;

	for (;;) {

		//Sends an overview of the current status
		if (fg_status) {
			//size =sprintf(texto,"Counter = %d	Tempo de delay = %d	Fg_start = %d	RPM = %d	\n",counter, PULSE_DELAY, fg_Start, RPM);
			size = sprintf(texto, "Irms = %d\n", Irms);
			HAL_UART_Transmit(&huart2, texto, size, 100);
			osDelay(100);
		}

		if (HAL_UART_Receive(&huart2, tempo_serial, 3, 1) == HAL_OK) {

			if (tempo_serial[0] == 'u') {
				tempo_serial[0] = tempo_serial[1];
				tempo_serial[1] = tempo_serial[2];
				tempo_serial[2] = 0;
				tempo_serial[3] = 0;

				tempo_up = atoi(tempo_serial);
				tempo_up *= 1000;
				fg_serial = 1;
			}

			if (tempo_serial[0] == 'd') {
				tempo_serial[0] = tempo_serial[1];
				tempo_serial[1] = tempo_serial[2];
				tempo_serial[2] = 0;
				tempo_serial[3] = 0;

				tempo_down = atoi(tempo_serial);
				tempo_down *= 1000;
				fg_serial = 1;
			}

			if (tempo_serial[0] == '$') {
				size = sprintf(texto, "I%i;R%i\n", Irms, RPM);
				HAL_UART_Transmit(&huart2, texto, size, 100);
			}

		}

		//Receives a single char from serial
		//HAL_UART_Receive(&huart2, &rx, 1, 1);
		//osDelay(1);

		//u stands for changing the acceleration time
		if (rx == 'u') {
			if (HAL_UART_Receive(&huart2, tempo_serial, 2, 5000) == HAL_OK) {
				tempo_up = atoi(tempo_serial);
				tempo_up *= 1000;

				fg_serial = 1;
//				if (RampUp == 1 && fg_End == 1) {
//					tempo = tempo_up;
//					counter = tempo;
//					fg_Start = 1;
//					fg_End = 0;
//				}

			} else {
				size = sprintf(texto, "TIMEOUT - Acceleration Time\n");
				HAL_UART_Transmit(&huart2, texto, size, 100);
			}
		}

		//d stand for changing the deceleration time
		if (rx == 'd') {
			if (HAL_UART_Receive(&huart2, tempo_serial, 2, 5000) == HAL_OK) {
				tempo_down = atoi(tempo_serial);
				tempo_down *= 1000;

				fg_serial = 1;

//				fg_Start = 1;
//				fg_End = 0;
//				HAL_GPIO_WritePin(bypass_relay_GPIO_Port, bypass_relay_Pin,
//						GPIO_PIN_RESET);

				//counter = 0;

			} else {
				size = sprintf(texto, "TIMEOUT - Deceleration Time\n");
				HAL_UART_Transmit(&huart2, texto, size, 100);
			}
		}

		//t stand for toggling the status through the serial
		if (rx == 't') {
			if (fg_status == 0)
				fg_status = 1;
			else
				fg_status = 0;
		}

		//c stand for defining the new relation of current
		if (rx == 'c') {
			if (HAL_UART_Receive(&huart2, tempo_serial, 3, 3000) == HAL_OK) {
				relation = 1;
				osDelay(250);
				relation = Irms;
				relation /= atoi(tempo_serial);

				corrente_nominal = atoi(tempo_serial);

				//relation = Irms/atoi(tempo_serial);
			}
		}

		//h stand for printing a serial command list
		if (rx == 'h') {
			size =
					sprintf(texto,
							"LIST OF SERIAL COMMANDS:\nu - Changes the acceleration time\nd - changes the deceleration time\nt - toggles the status through the serial\nh - prints the help menu\n");
			HAL_UART_Transmit(&huart2, texto, size, 100);
		}

		if (rx == '#') {
			size = sprintf(texto, "u %i d %i\n", tempo_up, tempo_down);
			HAL_UART_Transmit(&huart2, texto, size, 100);
		}

		rx = 0;
		osDelay(1);
	}
	/* USER CODE END SerialTask */
}

/* OverCurrentTask function */
void OverCurrentTask(void const * argument) {
	/* USER CODE BEGIN OverCurrentTask */
	/* Infinite loop */
	float ADC_value[16];
	int index = 0;
	int aux;
	int result;
	int rms;
	int Medidas_ADC = 16;
	int sum[32];

	for (;;) {
		if (fg_ADC_current) {
			fg_ADC_current = 0;

			for (aux = 0; aux < Medidas_ADC; aux++) { //Faz com que o valor seja de 311 de pico com 2v na entrada
				//ADC_value[aux] = (adc_current[aux] / relation); //Rela��o entre 311 e o valor do AD pra 2v
				ADC_value[aux] = (adc_current[aux]); //Rela��o entre 311 e o valor do AD pra 2v
			}

			rms = 0;
			for (aux = 0; aux < Medidas_ADC; aux++) {
				rms += pow(ADC_value[aux], 2);
			}

			rms = sqrt((rms / Medidas_ADC));

			rms /= relation;

			if (index > 31) {
				index = 0;
				Irms = 0;
				for (aux = 0; aux < 32; aux++) {
					Irms += sum[aux];
				}
				Irms /= 32;
				Irms -= 5;
				if (Irms < 0)
					Irms = 0;
			}

			sum[index] = rms;
			index++;
			//quando der overcurrent mandar um "i" via serial (S� O CARACTER)
			//quando der overvoltage mandar um "v" via serial (S� O CARACTER)

		}

		osDelay(10);
	}
	/* USER CODE END OverCurrentTask */
}

/* Comeca_Task function */
void Comeca_Task(void const * argument) {
	/* USER CODE BEGIN Comeca_Task */
	/* Infinite loop */
	char texto[50];
	int size;

	tempo = tempo_up;
	counter = tempo;

	HAL_ADC_Start_DMA(&hadc1, (uint32_t *) adc_current, 16); //N�O CONSIGO FAZER ESSA PORRA FUNCIONAR!!!!!
	HAL_TIM_Base_Start(&htim3);
	HAL_TIM_Base_Start(&htim1);

	HAL_TIM_PWM_Start(&htim2, TIM_CHANNEL_1);

	__HAL_TIM_SET_AUTORELOAD(&htim2, PULSE_DELAY + PULSE_WIDTH - 1);
	__HAL_TIM_SET_COMPARE(&htim2, TIM_CHANNEL_1, PULSE_DELAY);

	size = sprintf(texto, "Iniciando perifericos");
	HAL_UART_Transmit(&huart2, texto, size, 100);

	vTaskSuspend(ComecaHandle);

	size = sprintf(texto, "fechando perifericos");
	HAL_UART_Transmit(&huart2, texto, size, 100);

	for (;;) {
		osDelay(1);
	}
	/* USER CODE END Comeca_Task */
}

/* RPMTask function */
void RPMTask(void const * argument) {
	/* USER CODE BEGIN RPMTask */
	/* Infinite loop */
	int size;
	char texto[100];
	for (;;) {
		RPM = __HAL_TIM_GET_COUNTER(&htim1);
		RPM *= 60;

		size = sprintf(texto, "RPM: %d\n", RPM);
		//HAL_UART_Transmit(&huart2, texto, size, 100);

		__HAL_TIM_SET_COUNTER(&htim1, 0);

		osDelay(1000);
	}
	/* USER CODE END RPMTask */
}

/**
 * @brief  Period elapsed callback in non blocking mode
 * @note   This function is called  when TIM11 interrupt took place, inside
 * HAL_TIM_IRQHandler(). It makes a direct call to HAL_IncTick() to increment
 * a global variable "uwTick" used as application time base.
 * @param  htim : TIM handle
 * @retval None
 */
void HAL_TIM_PeriodElapsedCallback(TIM_HandleTypeDef *htim) {
	if (htim->Instance == TIM11) {
		HAL_IncTick();
	}
}

/**
 * @brief  This function is executed in case of error occurrence.
 * @param  file: The file name as string.
 * @param  line: The line in file as a number.
 * @retval None
 */
void _Error_Handler(char *file, int line) {
	/* USER CODE BEGIN Error_Handler_Debug */
	/* User can add his own implementation to report the HAL error return state */
	while (1) {
	}
	/* USER CODE END Error_Handler_Debug */
}

#ifdef  USE_FULL_ASSERT
/**
 * @brief  Reports the name of the source file and the source line number
 *         where the assert_param error has occurred.
 * @param  file: pointer to the source file name
 * @param  line: assert_param error line source number
 * @retval None
 */
void assert_failed(uint8_t* file, uint32_t line)
{
	/* USER CODE BEGIN 6 */
	/* User can add his own implementation to report the file name and line number,
	 tex: printf("Wrong parameters value: file %s on line %d\r\n", file, line) */
	/* USER CODE END 6 */
}
#endif /* USE_FULL_ASSERT */

/**
 * @}
 */

/**
 * @}
 */

/************************ (C) COPYRIGHT STMicroelectronics *****END OF FILE****/
