dfantonio/Softstarter-using-ARM-STM32F411/Softstarter.ioc

Mcu.UserName=STM32F411RETx
PA0-WKUP.Signal=S_TIM2_CH1_ETR
PA1.Signal=S_TIM2_CH2
PA2.Signal=USART2_TX
PA3.Signal=USART2_RX
PA4.Signal=ADCx_IN4
PA5.GPIO_Label=LED
PA5.Signal=GPIO_Input
PA6.GPIO_Label=bypass_relay
PA6.Signal=GPIO_Output
PA8.Signal=S_TIM1_CH1
PB6.Signal=S_TIM4_CH1
PC10.GPIO_Label=Green_LED
PC10.Signal=GPIO_Output
PC11.GPIO_Label=Yellow_LED
PC11.Signal=GPIO_Output
PC12.GPIO_Label=Red_LED
PC12.Signal=GPIO_Output
PC13-ANTI_TAMP.GPIO_Label=Button
PC13-ANTI_TAMP.Signal=GPIO_Input
