dfantonio/Softstarter-using-ARM-STM32F411/(commit log)

2018-07-13 Added some schematics
    [Disparo pro TRIAC.pdsprj, Retificador de precisão.pdsprj, Zero Crossing Detector.pdsprj]
2018-07-16 Bypass relay implemented
2018-08-21 Overcurrent Task
    Adicionei a medida de over voltage e a função para mandar via seria os caracteres de aviso
2018-08-23 Over current and voltage in serialtask
2018-08-28 Measure Current
2018-09-01 Working ADC
    Now the current is being properly measured
2018-09-17 SoftStarter Completed
    IT'S DONE!!!!
    More especifically, now the code has current measurement and overcurrent protection, RPM measure and new serial commands.
    [Softstarter.cfg]
